GliderWinchItems/BMScable/README.md

# BMSCable
Battery Management System Cable testing unit

Test the cable from the battery module (before connecting to the BMS control pcb!).
