GliderWinchItems/BMScable/pcb/docs/description/BMSCable.odt

Overview

The BMScable pcb fulfills the primary function of testing the battery module cable (ribbon cable with IDC connector) from the cells to the BMS board for correct wiring prior to plugging the cable into the BMS board. A wrong connection has the possibility of ruining the BMS unit.

A secondary use of the BMScable board might be monitoring the cell and battery string voltages and controlling the on/off of an external charger to that battery string.

In its rudimentary configuration the BMScable board is not isolated from the battery and a usb connection places the computer at the battery string ground.

The basic function is to measure all pins of the battery module cable, with respect to the expected ground pin, and determine if the voltages are within limits for a correctly connected cable. Since any wire might carry full battery module voltage all the pins, except for ground, connect to a resistor divider that drops the maximum possible voltage to be within the limit of the processor ADC.

Since the processor can only handle 16 inputs, three addition measurements are provided by switching three ADC inputs between six IDC pins. Three of the connectors are for measuring battery current, plus a Kelvin ground. Two DPDT relays are used switch these inputs, (one of the relay poles unused).

Since the three wires expected to be essentially ground when correctly wired are checked for voltage near zero, which expected for a correct connection; above the voltage for a single cell a low charge, which would signal an incorrect wiring; and, in between these two limits if the wire is open-circuit. A large pull-up resistor to 5v provides the voltage to the divider that will show open circuit.

When the relays are energized all the ADC inputs connect to the 16 battery module cells (via the resistor divider).

Individual cell voltages can be computed by taking the difference between cell readings (but with starting with cell #1 and ground). Since the resistor divider divides by nearly 20x, the difference between cell readings is magnified. Individual cell voltages can have an error upwards of +/- 0.12v, with cell pairs having showing the plus and the other showing the minus error.

PCB layout features

The pcb layout was made with the intent to be able to use it with a STM32 Nucleo board, or mount a STM32F405,407,446, or STM32L431 directly onto the pcb. The board fab, PCBCart.com, offers an inexpensive proto-type service, but that service does not include solder stop mask between smd pads for the processor. If attempts to mount the processor on the pcb resulted in difficulties with solder bridges, then the boards could be used with the Nucleo boards. The layout included headers that would mate with the Nucleo board.

The direct mounting of a STM32L431RBT6 proved satisfactory so the assembly and the following do not include the provisions for the configuration with the Nucleo board.

Serial port monitoring is via usb-serial module that can be mounted with headers. The usb can supply the ~5v for running the processor. The header JP2 requires a jumper to supply the 5v from the usb-serial module.

Note: The usb-serial module should not have the jumper in place.

The 2x10 IDC connector is keyed so that the ribbon cable connector only inserts in one orientation.

A reset pushbutton is located near the IDC connector.

A 3-pin keyd connector, also near the IDC connector, is for connecting the fet to something external to turn an external charger on/off, e.g. an external relay, or solid-state relay. A flyback diode is included in case a relay is used.

A two pin header was mounted on the lower 2x20 header in the ground positions. This two pin header provides a ground connection for a VOM.

A one-pin header is tack-mounted on the +3.3v output of the 5→3.3v regulator. This provides a convenient place for a VOM to measure Vdd. This voltage source can be used for testing.

All pins except pin #3 on the IDC connector connect to resistors.

Schottky diodes are included to prevent negative voltages on the ADC inputs should the ribbon cable be backwards (which would occur if the IDC connector was crimped on incorrectly).

Wiring

A 20 wire, multi-color ribbon is used. The cell designation for the wires has the ribbon split so for an upper section goes on top of the battery module, and a lower section to the underside. The cell connections are made so that the wires peel off the ribbon in order as it progresses down the top, and bottom, sides of the battery module. This results in the following cell number versus ribbon color, versus IDC connector pin number.

X

Flashing & Debugging

Header JP6 SWD connects to a Nucleo or DiscoveryFx board SWD for flashing and debugging using the STLink. On the Nucleo, or other,

1) Remove the two jumpers to enable the SWD header.

2) On the Nucleo board enable the 5v from the USB by a jumper, U5V on jp5, to power ST-Link processor (not needed on the Discovery boards).

3) The BMScable board is powered via the USB-serial cable.

The STLink connections between the two boards--

Nucleo/DiscoverFx

BMScable

1

2 2

3 1 (gnd)

4 3

5

6

On the PC, openocd the following configuration command opens the openocd server for debugging--

openocd -f interface/stlink.cfg -f target/stm32l4x.cfg

Something similar to the following should be seen--

openocd -f interface/stlink.cfg -f target/stm32l4x.cfg

Open On-Chip Debugger 0.11.0+dev-00282-gae6de2f93-dirty (2021-07-29-16:35)

Licensed under GNU GPL v2

For bug reports, read

http://openocd.org/doc/doxygen/bugs.html

Info : auto-selecting first available session transport "hla_swd". To override use 'transport select <transport>'.

Info : The selected transport took over low-level target control. The results might differ compared to plain JTAG/SWD

Info : DEPRECATED target event trace-config

Info : Listening on port 6666 for tcl connections

Info : Listening on port 4444 for telnet connections

Info : clock speed 500 kHz

Info : STLINK V2J38M27 (API v2) VID:PID 0483:374B

Info : Target voltage: 3.255445

Info : stm32l4x.cpu: hardware has 6 breakpoints, 4 watchpoints

Info : starting gdb server for stm32l4x.cpu on 3333

Info : Listening on port 3333 for gdb connections

[Sucess in connecting]

Sometimes the flashing of the 'L431 ends with failure with a message about failing to erase. When this happens often it works with the next './mm' try. Sometimes it takes unplugging/repowering. Sometimes pressing the reset pushbutton on the BMScable board starts it. I’m not sure what is going on. Most of the time it works OK.

In another window the following starts the rudimentary debugger--

telnet localhost 4444

Program

The program makes use of prior routines and as such may include code not used in this application.

The ADC parameters are initialized with a call to the routine in adc_idx_v_struct.c. A default calibration based on nominal values is first set, and specific calibrations replace the values based on #ifdef--#endif sections which select the board number.

Don’t forget to use the correct the #define to select the board number.

ADCTask.c runs the task that handles the ADC.

Sixteen ADCs are read using DMA in a continuous scan mode. The auto injection is set so that following the 16th conversion the injection sequence is started. This sequence measures the internal voltage reference and internal temperature sensor. Upon DMA interrupt the prior injection data registers are stored.

Upon interrupt, the DMA half buffer with the readings just completed are summed. After 16 summations the summations for the sixteen inputs are converted to floats and pasted through single-pole filters. The buffers are swapped and ‘main’ is given a notification.

main.c waits for notifications and counts notifications to reduce the output rate. The output (subject to change) presents column headers for the cell number, ribbon color, and connector pin number. The data rows present the ribbon voltages and on the following line the differences which should be the individual cell voltages.

The header with the cell number has three forms--

- Cell OK: e.g. ‘1 ’

- Cell too low: e.g. ‘1 LO’

-Cell too hi: e.g. ‘1 HI’

The calibration adc_idx_v_struct.c sets the threshold for the high and low limits. When the voltage is outside these limits the fet for controlling an external charger is off. When within the limits the external fet is turned on if the overall battery module voltage (16th cell voltage) is not too high.

Cable not plugged in--

PIN# 13 5 14 6 15 7 16 8 17 9 18 10 19 11 20 12

COLORGRY BLU PUR GRN BLU YEL GRN ORG YEL RED ORG BRN RED BLK BRN WHT

CELL 1 LO 2 LO 3 LO 4 LO 5 LO 6 LO 7 LO 8 LO 9 LO 10 LO 11 LO 12 LO 13 LO 14 LO 15 LO 16 LO

D: 0.0000 0.0000 -0.0000 0.0000 0.0000 0.0000 0.0000 0.0000 0.0000 0.0000 0.0000 0.0000 0.0000 0.0000 0.0000 0.0000

N: 0.0000 0.0000 0.0000 0.0000 0.0000 0.0000 0.0000 0.0000 0.0000 0.0000 0.0000 0.0000 0.0000 0.0000 0.0000 0.0000

STATUS: FET OFF : Vref 12045 Vtemp 7426

Z: SRN OPEN 2.308 SRP OPEN 2.302 C0 OPEN 2.292

Cable plugged in--

PIN# 13 5 14 6 15 7 16 8 17 9 18 10 19 11 20 12

COLORGRY BLU PUR GRN BLU YEL GRN ORG YEL RED ORG BRN RED BLK BRN WHT

CELL 1 2 3 4 5 6 7 8 9 10 11 12 13 14 15 16

D: 3.8922 3.8467 3.8661 3.8444 3.9163 3.7115 3.8851 3.8984 3.8910 3.8100 3.8843 3.8903 3.8054 3.9127 3.8813 3.8813

N: 3.8922 7.7389 11.6051 15.4494 19.3657 23.0773 26.9623 30.8607 34.7518 38.5618 42.4461 46.3364 50.1418 54.0545 57.9358 61.8171

STATUS: FET ON : Vref 12033 Vtemp 7502

Z: SRN GOOD 0.000 SRP GOOD 0.000 C0 GOOD 0.000

LEDs

Two processor controlled LEDs (located near JP6 SWD header)--

The red led (next to the green led) is ON with the fet is ON.

The green led flashes to indicate normal program

Both flashing together gives the Morse code trap code number.

Two polarity check LEDs (located at board edge near IDC connector--

The green LED indicates correct ribbon polarity.

The red LED indicates the ribbon/IDC is backwards.

Calibration

Each ADC input requires a calibration. To ease the burden the following scheme using the spreadsheet GliderWinchItems/BMScable/pcb/docs/calibration/calibration-aids.ods can be used.

1) Measure the ground-to-cell voltages and enter them in the horizontal row of the spreadsheet labelled VOM measurement.

2) Copy the existing calibration table in adc_idx_v_struct.c and paste into the spreadsheet “top” list of calibrations in the spreadsheet (paste to cell A18).

3) Copy the newly computed calibration table from the “bottom” list of calibrations (copy A37:D55, don’t forget the “;” column) and paste into adc_idx_v_struct.c

4) Convert the spreadsheet right arrow p→ to p-> with find and “replace all”.

5) Recompile

BMScable unit – Description and notes 08/22/2021 Page 6
