GliderWinchItems/BMScable/pcb/openscad/pcb-frame.stl

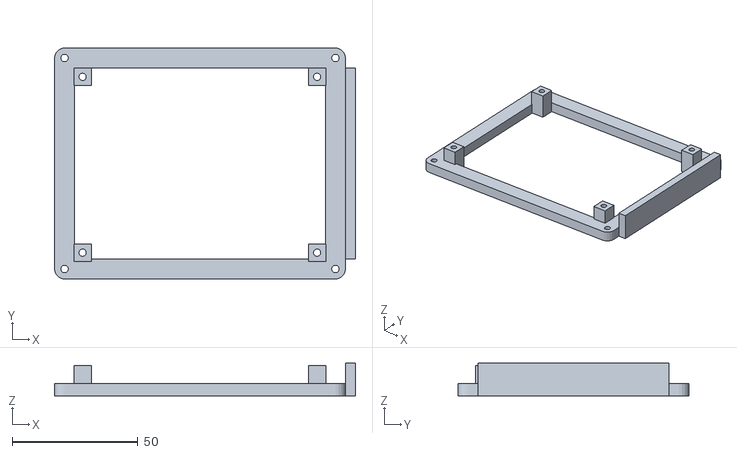
[picture p6: CAD file, 2021-08-24]
pcb/openscad/pcb-frame.stl
119.9 x 92.0 x 13.0
