GliderWinchItems/BMScable/perf/hw/eagle/pinusage.ods

 | Nucleo446R |  |  |  |  | 07/24/20
Row |  | Processor | Nucleo |  |  |  |  | Nucleo
Seq # |  | pin | CN7 | CN10 |  |  |  | note
1 | PA00 | 14 | 28 |  | ADC123-IN0 | C1 | PUSHBUTTON (PULLUP)
2 | PA01 | 15 | 30 |  | ADC123-IN1 | C2
3 | PA02 | 16 |  | 35 | ADC123-IN2 | C3
4 | PA03 | 17 |  | 37 | ADC123-IN3 | C4
5 | PA04 | 20 | 32 |  | ADC123-IN4 | C5
6 | PA05 | 21 |  | 11 | ADC123-IN5 | C6
7 | PA06 | 22 |  | 13 | ADC123-IN6 | C7
8 | PA07 | 23 |  | 16 | ADC123-IN7 | C8
9 | PA08 | 41 |  | 23 | TIM1_CH1
10 | PA09 | 42 |  | 21 | USART1_TX | JP2-9 | FTDI
11 | PA10 | 43 |  | 33 | USART1_RX | JP2-10 | FTDI
12 | PA11 | 44 |  | 14 | CAN1_RX | JP2-4 | CAN-RX
13 | PA12 | 45 |  | 12 | CAN1_TX | JP2-3 | CAN-TX
14 | PA13 | 46 | 13 |  | SWDIO |  | JTMS
15 | PA14 | 49 | 15 |  | SWDCK |  | JTCK
16 | PA15 | 50 |  |  | --
17
18 | PB00 | 26 | 34 |  | ADC123_IN8 | C9
19 | PB01 | 27 |  | 24 | ADC123_IN9 | C10
20 | PB02 | 28 |  | 22 | BOOT1
21 | PB03 | 55 |  | 31 | OUT PP | Q12-FET-RELAY
22 | PB04 | 56 |  | 27 | --
23 | PB05 | 57 |  | 29 | CAN2-RX
24 | PB06 | 58 |  | 17 | CAN2-TX
25 | PB07 | 59 | 21 |  | I/O
26 | PB08 | 61 |  | 3 | TIM4CH3 | FET-CHGR-RELAY
27 | PB09 | 62 |  | 5 | OUTPUT
28 | PB10 | 29 |  | 25 | I2C2-SCL
29 | VCAP_1 | 30 |  |  | VCAP_1
30 | PB12 | 33 |  | 16 | CAN2-RX
31 | PB13 | 34 |  | 30 | CAN2-TX
32 | PB14 | 35 |  | 28 | I/O
33 | PB15 | 36 |  | 26 | I/O
34
35 | PC00 | 8 | 38 |  | ADC123-IN10 | C11
36 | PC01 | 9 | 36 |  | ADC123-IN11 | C12 | Nucleo PB8
37 | PC02 | 10 | 35 |  | ADC123-IN12 | C13 | Nucleo PB9
38 | PC03 | 11 | 37 |  | ADC123-IN13 | C14
39 | PC04 | 24 | 34 |  | ADC123_IN14 | C15|C17
40 | PC05 | 25 |  | 6 | ADC123-IN15 | C16|C18
41 | PC06 | 37 |  | 4 | TIM8CH1
42 | PC07 | 38 |  | 19 | TIM3CH2
43 | PC08 | 39 |  | 2 | SDIO-D0
44 | PC09 | 40 |  | 1 | SDIO-D1
45 | PC10 | 51 | 1 |  | SDIO-D2
46 | PC11 | 52 | 2 |  | SDIO-D3
47 | PC12 | 53 | 3 |  | SDIO-CK
48 | PC13 | 2 | 23 |  | --
49 | PC14 | 3 | 25 |  | OSC32_IN
50 | PC15 | 4 | 27 |  | OSC32_OUT
51
52 | PD2 | 54 | 4 |  | SDIO-CMD | U$26
53
54 | PH00 | 5 | 29 |  | OSC-IN | XTAL 8 MHZ
55 | PH01 | 6 | 31 |  | OSC-OUT | XTAL 8 MHZ
56
57 | VBAT | 1 | 33 |  |  |  |  | SB45 zero to VDD
58
59 | VDD | 64 | 5 |  | VCC
60 | VSS | 63 |  |  | GND
61
62 | VSS | 18 |  |  | GND |  |  | SB53 zero
63 | VDD | 19 |  |  | VCC
64 | VDD | 48 |  |  | VCC
65 | VSS | 47 |  |  | GND |  |  | SB33 zero
66
67 | VDD | 32 |  |  | VCC
68 | VSS | 31 | 8 |  | GND |  |  | SB38 zero
69
70 | VSSA | 12 |  | 32 | GND
71 | VDDA | 13 |  | 7 | VCC | via BEAD to VDD |  | SB57 zero
72
73 | BOOT0 | 60 | 7 |  | GND
74
75 | NRST | 7 | 14 |  | NRST | JP1-26 | ONBOARD PUSHBUTTON
76 |  | np | 9
77 |  | np | 10
78 | IOREF | np | 11
79 |  | np | 26
80 |  | np |  | 10
81 |  | np |  | 18
82 |  | np |  | 36
83 |  | np |  | 38
84 | +5V | np | 18
85 | E5V | np | 6
86 | U5V | np |  | 8
