GliderWinchItems/BMScable/pcb/docs/calibration/boards.ods

Sheet: Sheet1
docs/calibration/boards
 |  |  |  |  |  |  |  |  |  |  |  |  | 12 | 14 | 8 | 10 | 4 | 6 | 0 | 2 | 13 | 15 | 9 | 11 | 5 | 7 | 3 | 1
08/09/21 |  |  |  |  |  |  |  |  |  |  |  |  | 1 | 2 | 3 | 4 | 5 | 6 | 7 | 8 | 9 | 10 | 11 | 12 | 13 | 14 | 15 | 16
 |  |  |  |  |  |  |  |  |  |  |  |  | 51.1132 | 58.9712 | 35.383 | 43.2672 | 19.6037 | 27.304 | 3.9166 | 11.6635 | 54.7522 | 62.6399 | 39.1192 | 46.8919 | 23.4117 | 31.2286 | 15.5458 | 7.779
 |  |  |  |  |  |  |  |  |  |  |  |  | 3.9901 | 8.0683 | 11.9288 | 15.9575 | 20.0204 | 24.0409 | 28.3476 | 32.1452 | 36.2471 | 40.0529 | 43.7685 | 47.9679 | 56.2892 | 45.6854 | 59.8037 | 64.0693 | : 120 | 40 7516
 |  |  |  | Connector |  |  |  |  |  |  |  |  | 4 | 8 | 12 | 16 | 20 | 24 | 28 | 32 | 36 | 40 | 44 | 48 | 52 | 56 | 60 | 64
 | Vbat | ADC[x] | Ribbon color | pin number |  | Cal reading |  |  |  | ADC[INx] | Ribbon color | pin number | cell number | I/O Port |  | ADC() | cell()
 | 3.299 | 2 | BRN | 20 | PC1 | 3.346 | 1.014247 |  |  | 2 | BRN | 20 | 15 | PC1 |  | 1 | 13 | 12
 | 3.299 | 1 | RED | 19 | PC0 | 3.370 | 1.021522 |  |  | 1 | RED | 19 | 13 | PC0 |  | 2 | 15 | 14
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
