GliderWinchItems/BMScable/pcb/docs/calibration/calibration-aid.ods

Calibration-aid
08/22/21
 | Readings
 | 1 | 2 | 3 | 4 | 5 | 6 | 7 | 8 | 9 | 10 | 11 | 12 | 13 | 14 | 15 | 16
D: | 3.8891 | 3.8515 | 3.9967 | 3.9846 | 3.9764 | 3.7139 | 3.5913 | 4.1201 | 3.5226 | 4.2435 | 4.5077 | 3.4556 | 3.8726 | 3.4724 | 4.1809 | 4.3614
N: | 3.8891 | 7.7406 | 11.7373 | 15.7219 | 19.6983 | 23.4121 | 27.0035 | 31.1236 | 34.6462 | 38.8897 | 43.3974 | 46.853 | 50.7256 | 54.198 | 58.3789 | 62.7403
VOM measurement | 0.0000 | 0.0000 | 0.0000 | 0.0000 | 0.0000 | 0.0000 | 0.0000 | 0.0000 | 0.0000 | 0.0000 | 0.0000 | 0.0000 | 0.0000 | 54.5110 | 58.4060 | 62.3070
Ratio | #DIV/0! | #DIV/0! | #DIV/0! | #DIV/0! | #DIV/0! | #DIV/0! | #DIV/0! | #DIV/0! | #DIV/0! | #DIV/0! | #DIV/0! | #DIV/0! | #DIV/0! | 0.9942580 | 0.9995360 | 1.0069543
 | Calibration table
 | used for readings
p->cabs[ 0].scale = | 1.236120E-04 | ; | x
p->cabs[ 1].scale = | 1.211896E-04 | ; | x
p->cabs[ 2].scale = | 1.217631E-04 | ; | x
p->cabs[ 3].scale = | 1.215495E-04 | ; | x
p->cabs[ 4].scale = | 1.215893E-04 | ; | x
p->cabs[ 5].scale = | 1.206427E-04 | ; | x
p->cabs[ 6].scale = | 1.216620E-04 | ; | x |  |  |  |  |  |  |  |  |  |  | meter | board | ratio | update factor | value
p->cabs[ 7].scale = | 1.226831E-04 | ; | x |  |  |  |  |  |  |  |  |  |  | 62.0240 | 62.0028 | 1.00034192 | 1.211783E-04 | 1.211369E-04
p->cabs[ 8].scale = | 1.215362E-04 | ; | x
p->cabs[ 9].scale = | 1.201768E-04 | ; | x
p->cabs[10].scale = | 1.212922E-04 | ; | x
p->cabs[11].scale = | 1.218116E-04 | ; | x
p->cabs[12].scale = | 1.215921E-04 | ; | x
p->cabs[13].scale = | 1.221255E-04 | ; | x
p->cabs[14].scale = | 1.205759E-04 | ; | x
p->cabs[15].scale = | 1.211369E-04 | ; | x
p->cabs[16].scale = | 1.211369E-04 | ;
p->cabs[17].scale = | 1.211369E-04
New calibration = adjusted above calibration |  |  |  |  |  |  |  |  | nominal
p→cabs[ 0].scale = |  | 1.236120E-04 | ; | x |  |  |  |  | divider | Board #2 |  | After division
p→cabs[ 1].scale = |  | 1.211896E-04 | ; | x |  | R1 | R2 | R1+R2 | ratio | Vdd | Vdd/4095 | mv/lsb
p→cabs[ 2].scale = |  | 1.217631E-04 | ; | x |  | 680 | 33 | 713 | 0.04628331 | 3.3033 | 0.0008066667 | 0.0174
p→cabs[ 3].scale = |  | 1.215495E-04 | ; | x
p→cabs[ 4].scale = |  | 1.215893E-04 | ; | x
p→cabs[ 5].scale = |  | 1.206427E-04 | ; | x
p→cabs[ 6].scale = |  | 1.216620E-04 | ; | x
p→cabs[ 7].scale = |  | 1.226831E-04 | ; | x
p→cabs[ 8].scale = |  | 1.215362E-04 | ; | x
p→cabs[ 9].scale = |  | 1.201768E-04 | ; | x
p→cabs[10].scale = |  | 1.212922E-04 | ; | x
p→cabs[11].scale = |  | 1.218116E-04 | ; | x
p→cabs[12].scale = |  | 1.215921E-04 | ; | x
p→cabs[13].scale = |  | 1.221255E-04 | ; | x
p→cabs[14].scale = |  | 1.205759E-04 | ; | x
p→cabs[15].scale = |  | 1.211369E-04 | ; | x
p→cabs[16].scale = |  | 1.211369E-04 | ;
p→cabs[17].scale = |  | 1.211369E-04 | ;
