GliderWinchItems/BMScable/pcb/docs/calibration/board2.ods

docs/alibration/board2
08/09/21
 |  |  |  | Connector
 | Vbat | ADC[x] | Ribbon color | pin number |  | Cal reading
 | 3.299 | 2 | BRN | 20 | PC1 | 3.346 | 1.014247
 | 3.299 | 1 | RED | 19 | PC0 | 3.370 | 1.021522
 | 3.299 | 4 | ORG | 18 | PC3 | 3.349 | 1.015156
 | 3.299 | 3 | YEL | 17 | PC2 | 3.351 | 1.015762
 | 3.299 | 6 | GRN | 16 | PA1 | 3.373 | 1.022431
 | 3.299 | 5 | BLU | 15 | PA0 | 3.345 | 1.013944
 | 3.299 | 8 | PUR | 14 | PA3 | 3.343 | 1.013337
 | 3.299 | 7 | GRY | 13 | PA2 | 3.374 | 1.022734
 | 3.299 | 10 | WHT | 12 | PA5 | 3.347 | 1.014550
 | 3.299 | 9 | BLK | 11 | PA4 | 3.372 | 1.022128
 | 3.299 | 12 | BRN | 10 | PA7 | 3.404 | 1.031828
 | 3.299 | 11 | RED | 9 | PA6 | 3.357 | 1.017581
 | 3.299 | 14 | ORG | 8 | PC5 | OC |  | RY2-2-NC
 | 3.299 | 13 | YEL | 7 | PC4 | OC
16? | 3.299 | 15 | GRN | 6 | PB0 | 3.390 | 1.027584 | RY2-1-NC
15? | 3.299 |  | BLU | 5 | PB1 | OC |  | RY1-2-NC
 | C0 |  | PUR | 4
 | ground |  | GRY | 3
 | SRN |  | WHT | 2
 | SRP |  | BLK | 1
 | 3.299 |  | Vrefint |  |  | 3.303 |  | 1.001212
 |  |  | Vtemp |  |  | 924.17
BOARD #2 | 08/10/21
 |  |  | 0 | 1 | 2 | 3 | 4 | 5 | 6 | 7 | 8 | 9 | 10 | 11 | 12 | 13 | 14 | 15 | 16
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
