GliderWinchItems/BMScable/pcb/BMScableL431/eagle/bmscableL431.brd

## EAGLE design pcb/BMScableL431/eagle/bmscableL431.brd (2021-02-24)

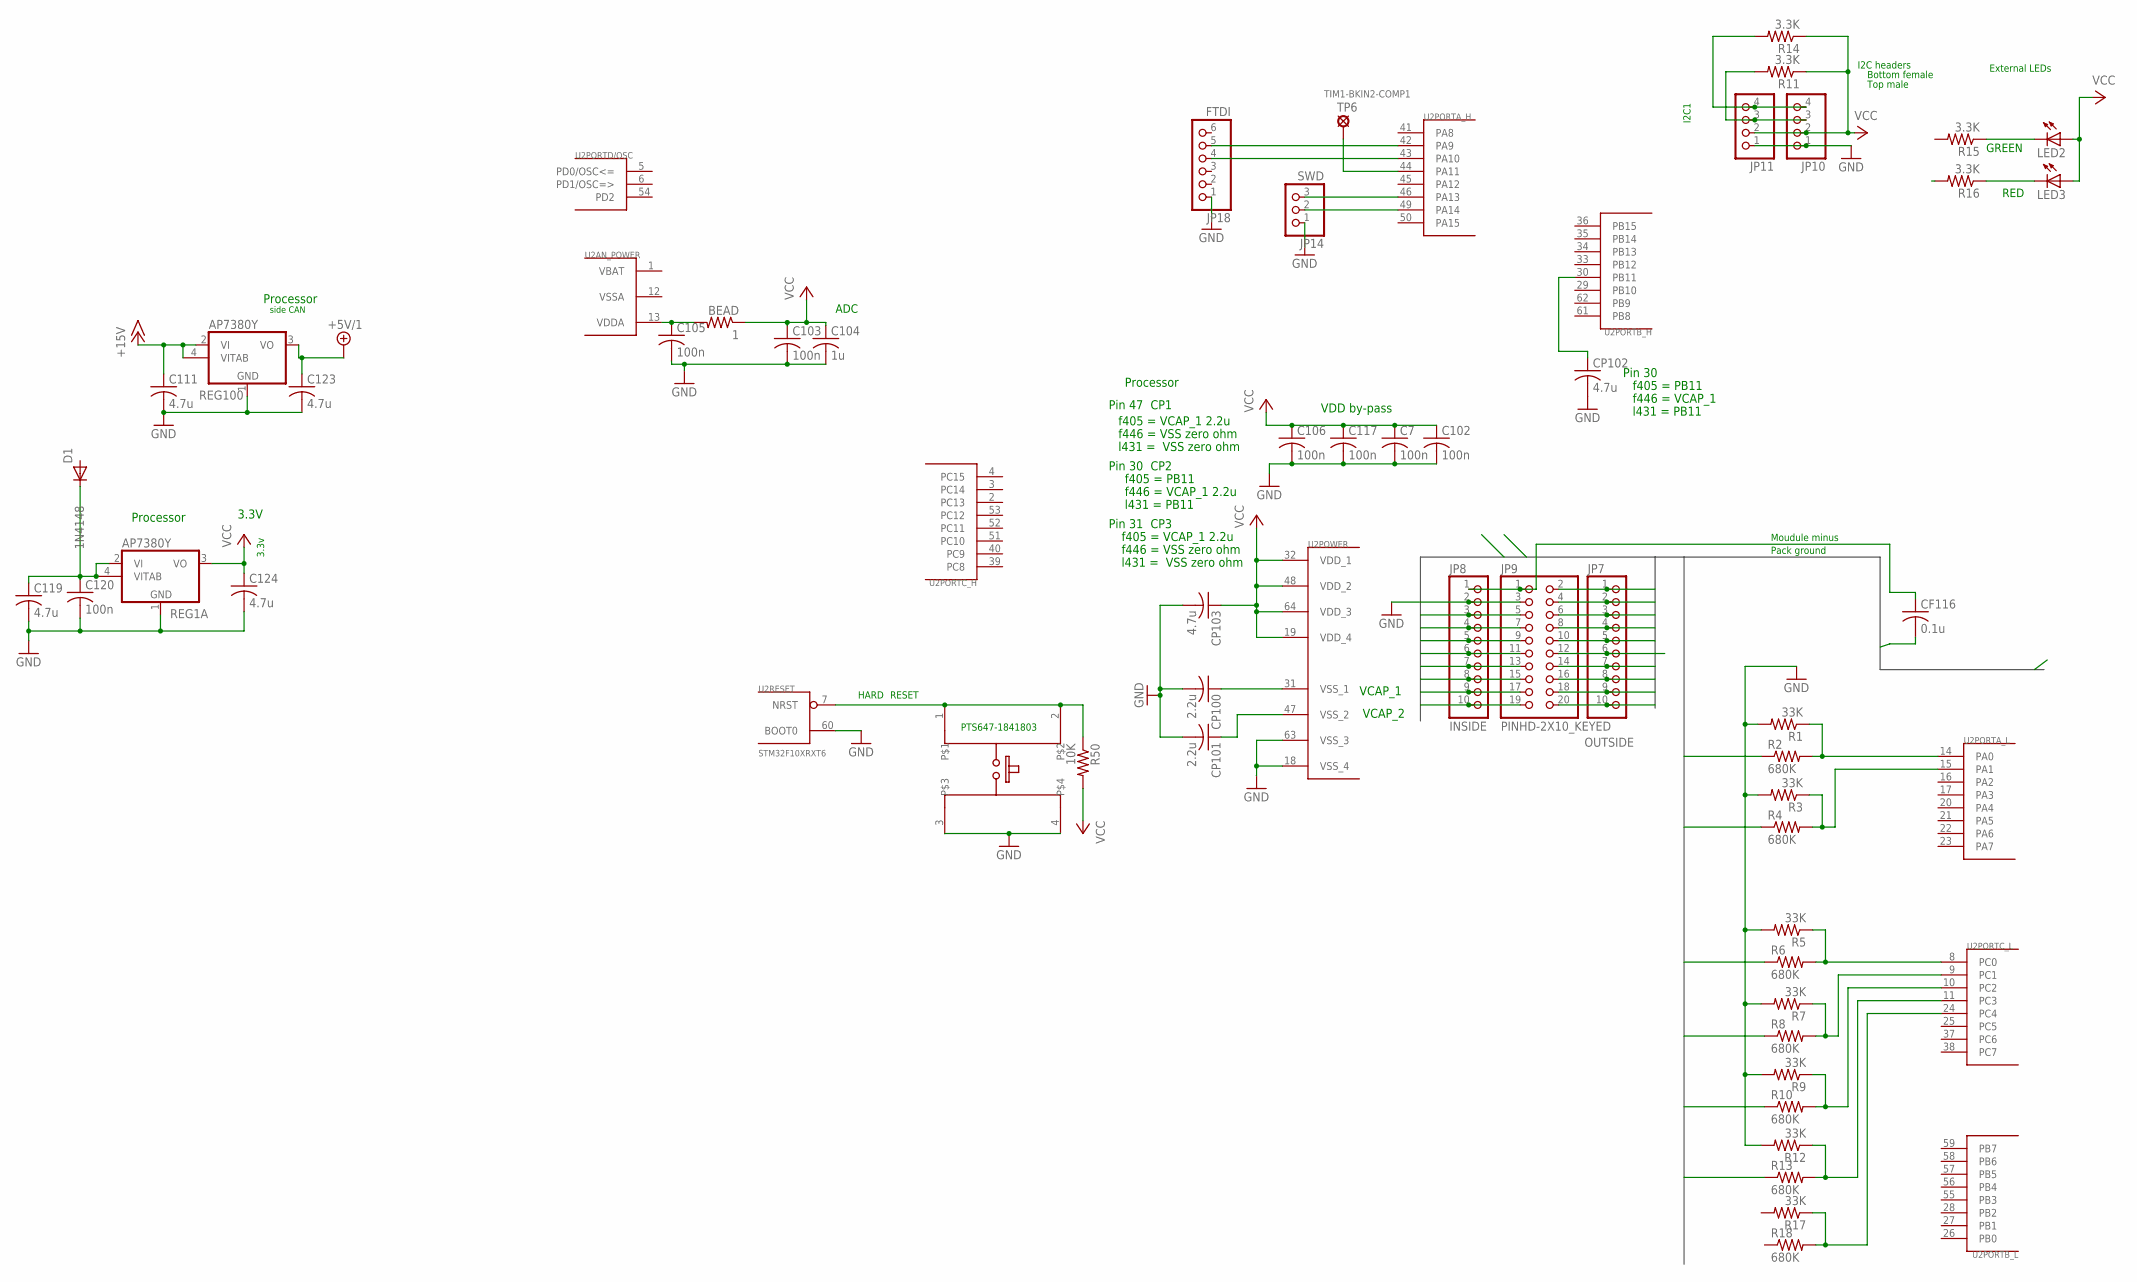
[picture p7: schematic bmscableL431.sch]

Parts:
BEAD: 1; R0603
C7, C102, C103, C105, C106, C117, C120: 100n; C0603
C104: 1u; C0603
C111, C119, C123: 4.7u; C0603
C124: 4.7u; C0805
CF116: 0.1u; C0603
CP100, CP101: 2.2u; C0603
CP102, CP103: 4.7u; C0603
D1: 1N4148; DO41-10_VERT
JP7: OUTSIDE; 1X10
JP8: INSIDE; 1X10
JP9: PINHD-2X10_KEYED; 2X10_KEYED
JP10, JP11: PINHD-1X4; 1X04
JP14: SWD; 1X03
JP18: FTDI; 1X06
LED2, LED3: LEDCHIP-LED0603; CHIP-LED0603
R1, R3, R5, R7, R9, R12, R17: 33K; R0603
R2, R4, R6, R8, R10, R13, R18: 680K; R0603
R11, R14, R15, R16: 3.3K; R0603
R50: 10K; R0603
REG1A, REG100: AP7380Y; SOT89
TP6: SOLDPAD0.6MM; SOLPAD.6MM
U2: STM32F10XRXT6; TQFP64
U$1: E-SWITCH2

Connections:
+5V/1: C123.1, REG100.3 (VO)
+15V: C111.1, REG100.2 (VI), REG100.4 (VITAB)
C0: JP7.2, JP9.4
C1: JP8.7, JP9.13
C2: JP8.3, JP9.5
C3: JP7.7, JP9.14, R4.1
C4: JP7.3, JP9.6
C5: JP8.8, JP9.15, R2.1
C6: JP8.4, JP9.7
C7: JP7.8, JP9.16, R13.1
C8: JP7.4, JP9.8
C9: JP8.9, JP9.17, R10.1
C10: JP8.5, JP9.9
C11: JP7.9, JP9.18, R8.1
C12: JP7.5, JP9.10
C13: JP8.10, JP9.19, R6.1
C14: JP8.6, JP9.11
C15: JP7.10, JP9.20
C16: JP7.6, JP9.12
GND: C7.2, C102.2, C103.2, C104.2, C105.2, C106.2, C111.2, C117.2, C119.2, C120.2, C123.2, C124.2, CP100.2, CP101.2, CP102.2, CP103.2, JP8.2, JP9.3, JP10.1, JP11.1, JP14.1, JP18.1, R1.2, R3.2, R5.2, R7.2, R9.2, R12.2, REG1A.1 (GND), REG100.1 (GND), U2.18 (VSS_4), U2.60 (BOOT0), U2.63 (VSS_3), U$1.3, U$1.4
LED-EXT-GRN-CATHODE: LED2.C, R15.1
LED-EXT-RED-CATHODE: LED3.C, R16.1
NRST: R50.1, U2.7 (NRST), U$1.1, U$1.2
PA0-C5-IN5: R1.1, R2.2, U2.14 (PA0)
PA1-C3-IN6: R3.1, R4.2, U2.15 (PA1)
PA9-USART1-TX: JP18.5, U2.42 (PA9)
PA10-USART1-RX: JP18.4, U2.43 (PA10)
PA13-SWDIO: JP14.3, U2.46 (PA13)
PA14-SWCLK: JP14.2, U2.49 (PA14)
PB1-LED-RED: R16.2
PB6-I2C1-SCL: JP10.4, JP11.4, R14.2
PB7-I2C2-SDA: JP10.3, JP11.3, R11.2
PB11-I2C2-SDA|VCAP1: CP102.1, U2.30 (PB11)
PC0-C13-IN1: R5.1, R6.2, U2.8 (PC0)
PC1-C11-IN2: R7.1, R8.2, U2.9 (PC1)
PC2-C9-IN3: R9.1, R10.2, U2.10 (PC2)
PC3-C7-IN4: R12.1, R13.2, U2.11 (PC3)
PC4-CX-IN13: R17.1, R18.2, U2.24 (PC4)
PGND_SRN_V: CF116.1, JP8.1, JP9.1
SRP: CF116.2, JP7.1, JP9.2
TIM1_BKIN2_COMP2: TP6.MP, U2.44 (PA11)
V-ORED: C119.1, C120.1, D1.C, REG1A.2 (VI), REG1A.4 (VITAB)
VBAT: U2.1 (VBAT)
VCC: BEAD.1, C7.1, C102.1, C103.1, C104.1, C106.1, C117.1, C124.1, CP103.1, JP10.2, JP11.2, LED2.A, LED3.A, R11.1, R14.1, R50.2, REG1A.3 (VO), U2.19 (VDD_4), U2.32 (VDD_1), U2.48 (VDD_2), U2.64 (VDD_3)
VDDA1: BEAD.2, C105.1, U2.13 (VDDA)
VSSA: U2.12 (VSSA)
VSS_1-VCAP_1: CP100.1, U2.31 (VSS_1)
VSS_3: CP101.1, U2.47 (VSS_2)

Notes on the sheet:
RESET
HARD
3.3V
VCAP_1
VCAP_2
Pin 47
f405 = VCAP_1 2.2u
Pin 30
f446 = VCAP_1 2.2u
Pin 31
f446 = VSS zero ohm
CP1
CP3
f405 = PB11
f446 = VCAP_1
CP2
ADC
GREEN
RED
I2C headers
Bottom female
3.3v
Processor
PTS647-1841803
Moudule minus
Pack ground
External LEDs
side CAN
TIM1-BKIN2-COMP1
l431 = VSS zero ohm
l431 = PB11
VDD by-pass
Top male
I2C1

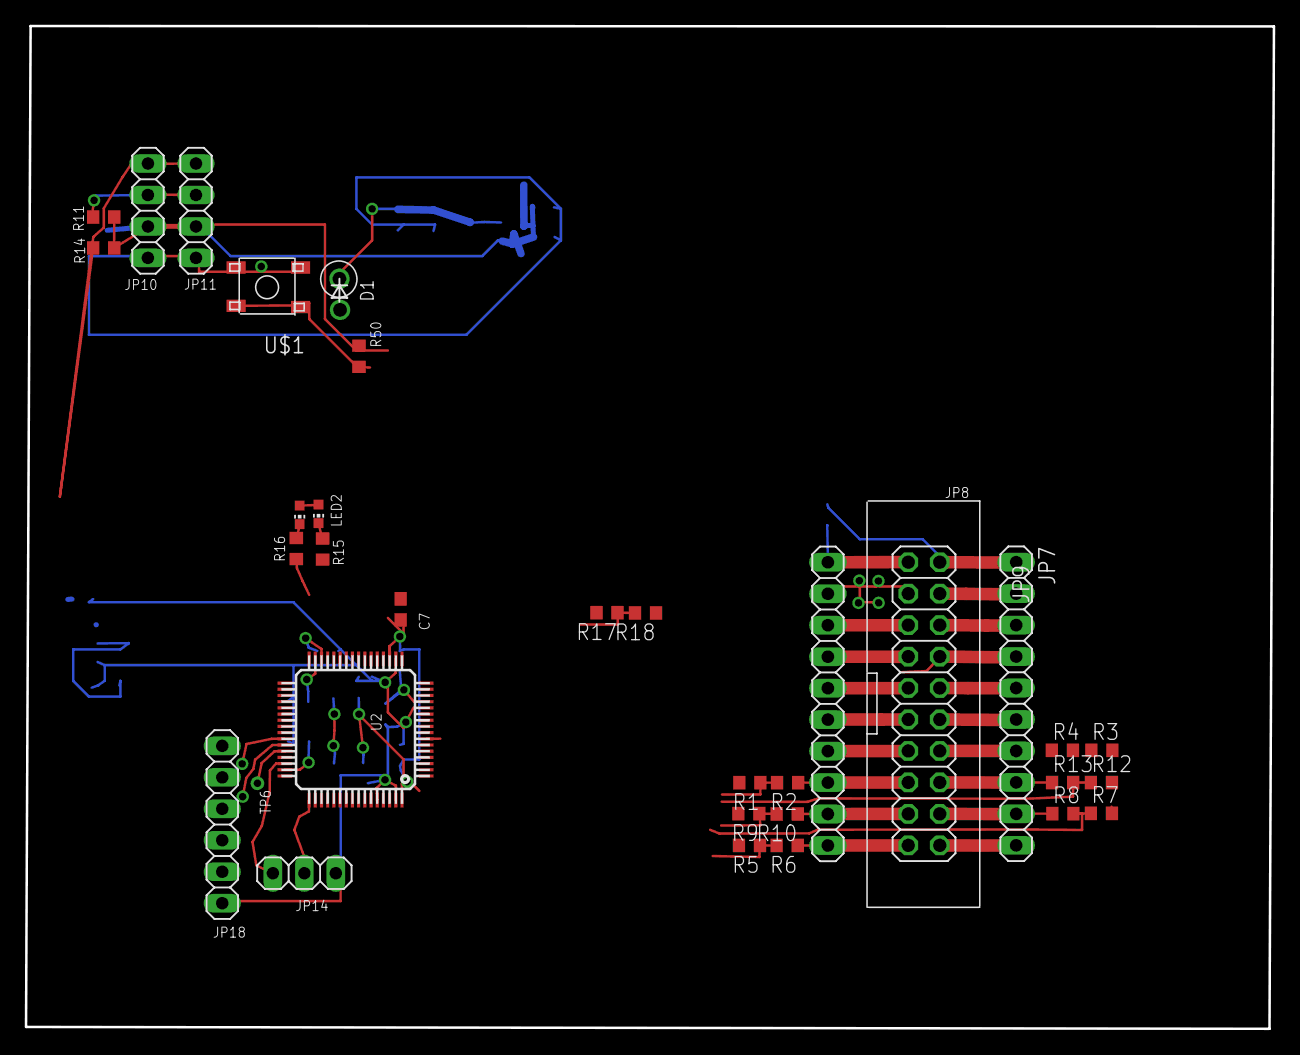
[picture p8: board bmscableL431.brd from above]

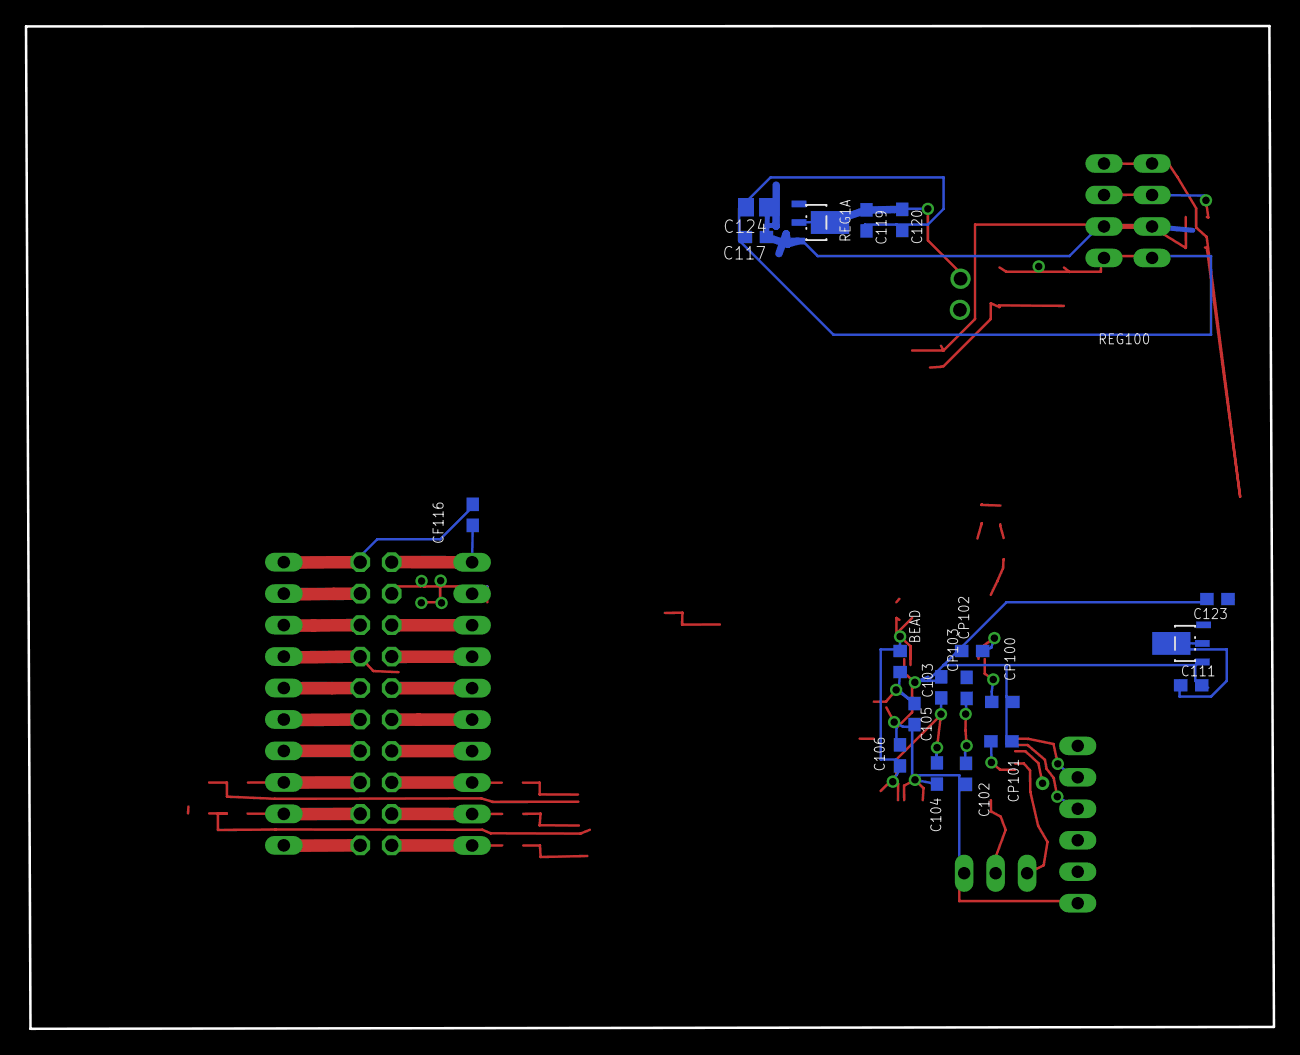
[picture p9: board bmscableL431.brd from below]

Board: 2 copper layers, 100.7 x 81.0 mm, 52 parts (19 on the bottom side), 45 nets.
