GliderWinchItems/BMScable/pcb/BMScableL431/Core/Src/main.c

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
/* Includes ------------------------------------------------------------------*/
#include "main.h"
#include "cmsis_os.h"

/* USER CODE BEGIN Includes */
#include <string.h>
#include "SerialTaskSend.h"
#include "getserialbuf.h"
#include "stackwatermark.h"
#include "yprintf.h"
#include "DTW_counter.h"
#include "SerialTaskReceive.h"
#include "yscanf.h"
#include "morse.h"

#include "FreeRTOS.h"
#include "semphr.h"

#include "adcparams.h"
#include "ADCTask.h"



/* USER CODE END Includes */

ADC_HandleTypeDef hadc1;
DMA_HandleTypeDef hdma_adc1;

CAN_HandleTypeDef hcan1;

UART_HandleTypeDef huart1;
DMA_HandleTypeDef hdma_usart1_rx;
DMA_HandleTypeDef hdma_usart1_tx;

/* Definitions for defaultTask */
osThreadId_t defaultTaskHandle;
const osThreadAttr_t defaultTask_attributes = {
  .name = "defaultTask",
  .stack_size = 384 * 4,
  .priority = (osPriority_t) osPriorityNormal,
};
void SystemClock_Config(void);
static void MX_GPIO_Init(void);
static void MX_DMA_Init(void);
static void MX_ADC1_Init(void);
static void MX_USART1_UART_Init(void);
static void MX_CAN1_Init(void);
void StartDefaultTask(void *argument);

/**
  * @brief  The application entry point.
  * @retval int
  */
int main(void)
{
  /* USER CODE BEGIN 1 */
  BaseType_t ret;    // Used for returns from function calls
  //osMessageQId Qidret; // Function call return
  osThreadId Thrdret;  // Return from thread create
  /* USER CODE END 1 */

  /* MCU Configuration--------------------------------------------------------*/

  /* Reset of all peripherals, Initializes the Flash interface and the Systick. */
  HAL_Init();

  /* USER CODE BEGIN Init */
  DTW_counter_init();
  /* USER CODE END Init */

  /* Configure the system clock */
  SystemClock_Config();

  /* USER CODE BEGIN SysInit */
/* Add bcb circular buffer to SerialTaskSend for usart1 -- PC monitor */
  #define NUMCIRBCB1  16 // Size of circular buffer of BCB for usart3
  ret = xSerialTaskSendAdd(&HUARTMON, NUMCIRBCB1, 1); // dma
  if (ret < 0) morse_trap(111); // Panic LED flashing
  /* USER CODE END SysInit */

  /* Initialize all configured peripherals */
  MX_GPIO_Init();
  MX_DMA_Init();
  MX_ADC1_Init();
  MX_USART1_UART_Init();
  MX_CAN1_Init();
  /* USER CODE BEGIN 2 */

  // Turn LEDs OFF
  HAL_GPIO_WritePin(GPIOB, GPIO_PIN_3|GPIO_PIN_4, GPIO_PIN_SET);

  /* USER CODE END 2 */

  /* Init scheduler */
  osKernelInitialize();

  /* USER CODE BEGIN RTOS_MUTEX */
  /* add mutexes, ... */
  /* USER CODE END RTOS_MUTEX */

  /* USER CODE BEGIN RTOS_SEMAPHORES */
  /* add semaphores, ... */
  /* USER CODE END RTOS_SEMAPHORES */

  /* USER CODE BEGIN RTOS_TIMERS */
  /* start timers, add new ones, ... */

  /* ADC summing, calibration, etc. */


  /* Setup semaphore for yprint and sprintf et al. */
  yprintf_init();

  /* USER CODE END RTOS_TIMERS */

  /* USER CODE BEGIN RTOS_QUEUES */
  /* add queues, ... */
  /* USER CODE END RTOS_QUEUES */

  /* Create the thread(s) */
  /* creation of defaultTask */
  defaultTaskHandle = osThreadNew(StartDefaultTask, NULL, &defaultTask_attributes);

  /* USER CODE BEGIN RTOS_THREADS */
  /* add threads, ... */
   Thrdret = xADCTaskCreate(1); // (arg) = priority
  if (Thrdret == NULL) morse_trap(117);
  
  /* Create serial task (priority) */
  // Task handle "osThreadId SerialTaskHandle" is global
  Thrdret = xSerialTaskSendCreate(osPriorityNormal); // Create task and set Task priority
  if (Thrdret == NULL) morse_trap(112);

  /* Create serial receiving task. */
  ret = xSerialTaskReceiveCreate(osPriorityNormal);
  if (ret != pdPASS) morse_trap(113);
  /* USER CODE END RTOS_THREADS */

  /* USER CODE BEGIN RTOS_EVENTS */
  /* add events, ... */
  /* USER CODE END RTOS_EVENTS */

  /* Start scheduler */
  osKernelStart();

  /* We should never get here as control is now taken by the scheduler */
  /* Infinite loop */
  /* USER CODE BEGIN WHILE */
  while (1)
  {
    /* USER CODE END WHILE */

    /* USER CODE BEGIN 3 */
  }
  /* USER CODE END 3 */
}

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
/* USER CODE BEGIN Header_StartDefaultTask */
/**
  * @brief  Function implementing the defaultTask thread.
  * @param  argument: Not used
  * @retval None
  */
uint32_t mctr = 0; // Debugging counter
uint32_t lctr = 20;
uint32_t ratectr = 0;
uint16_t* pjdr1 = (uint16_t*)(0x50040000 + 0x80); // Vrefint
uint16_t* pjdr2 = (uint16_t*)(0x50040000 + 0x80 + 0x04); // Vtemp
uint8_t diff = 0; // yprintf switch lines
uint8_t fet = 0;

/* Ribbon assignments of battery cable for use with BMSCable adaptor 
ribboncolorR = ribbon color sequence reversed from standard cables
ribboncolorS = ribbon color sequence standard 
pinnumberB   = IDC connector pin for battery cable (02/2022) */
char* ribboncolorR= "WHT     GRY     GRY     PUR     PUR     BLU     BLU     GRN     GRN     YEL     YEL     ORG     ORG     RED     RED     BRN    BRN    BLK";
char* ribboncolorS= "RED     ORG     ORG     YEL     YEL     GRN     GRN     BLU     BLU     PUR     PUR     GRY     GRY     WHT     WHT     BLK    BLK    BRN";
char* pinnumberB  = "12       3      13       4      14       5      15       6      16       7      17       8      18       9      19      10      20     11";
char* cellnumberB = " 1       2       3       4       5       6       7       8       9      10      11      12      13      14      15      16      17     18";

/* BQ ribbon assignment. */
char* ribboncolor = "GRY     BLU     PUR     GRN     BLU     YEL     GRN     ORG     YEL     RED     ORG     BRN     RED     BLK     BRN     WHT";
char* pinnumber   = "13       5      14       6      15       7      16       8      17       9      18      10      19      11      20      12 ";
char* cellnumber  = " 1       2       3       4       5       6       7       8       9      10      11      12      13      14      15      16 ";

char* test = "Quick Brown fox jumped over the lazy dogs back 0123456789\n\r";

/* USER CODE END Header_StartDefaultTask */
void StartDefaultTask(void *argument)
{
  /* USER CODE BEGIN 5 */
  uint32_t noteval = 0; // TaskNotifyWait notification word
  uint32_t notectr = 0; // Running count of notifications
  uint32_t notelim = 0; // Wait for notectr
  uint8_t state    = 0; // State machine sequence
//  uint8_t ledseq   = 0;

  struct SERIALSENDTASKBCB* pbuf1 = getserialbuf(&HUARTMON,256);
  if (pbuf1 == NULL) morse_trap(115);
  struct SERIALSENDTASKBCB* pbuf2 = getserialbuf(&HUARTMON,256);
  if (pbuf2 == NULL) morse_trap(116);

  yprintf(&pbuf1,"\n\rBegin %d",mctr++);

    HAL_GPIO_TogglePin(GPIOB,GPIO_PIN_3); // GRN LED
  /* Infinite loop */
  for(;;)
  {

    /* Wait for ADC new adc data (ADCTask.c) */
    xTaskNotifyWait(0,0xffffffff, &noteval, portMAX_DELAY);

   if (noteval & DEFAULTTASKBIT00)
   {
    notectr += 1;  // Running count of notifications



    /* Make monitor update rate reasonable. */
    ratectr += 1;
    if (ratectr < 2) continue;
    ratectr = 0;

    HAL_GPIO_TogglePin(GPIOB,GPIO_PIN_3); // GRN LED

    /* Index for just completed DMA buffer half. */
    uint8_t idxsum = adcsumidx ^ 1;
    float*   pfsum = &adcsumfilt[idxsum][0];
// STATES ------------------------------------------------------
#define RELAYDELAY 4
    switch (state)
    {
    case 0:
      lctr += 1; // Line counter for header
//HAL_GPIO_WritePin(GPIOB,GPIO_PIN_2 | GPIO_PIN_10,GPIO_PIN_RESET);
//#define SUMMEDINTEGER
#ifdef  SUMMEDINTEGER   
     uint32_t* psum = &adcsumdb[idxsum][0];
      if (lctr >= 8)
      {
        lctr = 0;
        yprintf(&pbuf1,"\n\rR%4u:",(adcommon.dmact - mctr));
        for (int i = 0; i < 16; i++)
        {
          yprintf(&pbuf1," %6u",(i+1));
        }
      }

      yprintf(&pbuf1,"\n\rI   :");
      for (int i = 0; i < 16; i++)
      {
        yprintf(&pbuf1," %6u",*(psum + i) );
      }
      mctr = adcommon.dmact;
#else
// Calibrated       

      float fprev = 0;
      float ftmp = 0;
      char* er;
      char* erhi = "HI";
      char* erlo = "LO";
      char* erno = "  ";
      char* erpack;
      char* erpackhi = "TOTALHI";
      char* erpackok = "TOTALOK";
      char* fetstatus;
      char* fetstatusoff = "FET OFF";
      char* fetstatuson  = "FET ON";

      extern uint32_t dwtdiff; 
  
      // Status line and column header
      if (*(pfsum + 15) > adc1.lc.flim_packhi)
      { // total voltage exceeds limit
        erpack = erpackhi;
        fet = 0; // Turn off external charger
      }
      else
      { // Total voltage not too high
        erpack = erpackok;
        fet = 1; // This may be turned off by the cell check
      }
      yprintf(&pbuf2,"\n\r\n%5d %s\n\r   ",dwtdiff,erpack);
 
      /* Header depends on adaptor, and battery box. */
    #define SIXTEENBOX
    #ifdef  SIXTEENBOX
      yprintf(&pbuf2,"\n\rPIN#   %s",pinnumberB);
      yprintf(&pbuf1,"\n\rREVRSE %s\n\r",ribboncolorR);
      yprintf(&pbuf1,"STNDRD %s\n\rCELL# ",ribboncolorS);
    #else
      yprintf(&pbuf2,"\n\rPIN#  %s",pinnumber);
      yprintf(&pbuf1,"\n\rCOLOR%s\n\rCELL",ribboncolor);
    #endif

      fprev = 0;
      for (int i = 0; i < 16; i++)
      {
        ftmp = *(pfsum + i) - fprev; // Individual cell volts
        er = erno; // default to no error
        if (ftmp > adc1.lc.flim_cellhi)
        { // Cell exceeds limit
          er = erhi; 
          fet = 0; // Turn off external charger
        }
        else if (ftmp < adc1.lc.flim_celllo)
        { // Cell too low for standard charge current
          er = erlo;
          fet = 0; // Turn off external charger
        }
        if (i == 0)
          yprintf(&pbuf2,"%3i %s",i+1,er);
        else
          yprintf(&pbuf2,"%5i %s",i+1,er);
        fprev = *(pfsum + i); 
      }  
  
      // Individual cells: Differences
      yprintf(&pbuf1,"\n\rD: ");
      fprev = 0;
      for (int i = 0; i < 16; i++)
      {
        yprintf(&pbuf1,"%7.4f ",*(pfsum + i) - fprev);
        fprev = *(pfsum + i);
      }

      // Battery string taps: ground-to-cell voltage
      yprintf(&pbuf1,"\n\rN:");
      for (int i = 0; i < 16; i++)
      {
        yprintf(&pbuf1,"%7.4f ",*(pfsum + i));
      }
      mctr = adcommon.dmact;

      // FET for external charger update
      if (fet == 0)
        fetstatus = fetstatusoff;
      else
        fetstatus = fetstatuson;

      // RED led on when external charger fet ON
      HAL_GPIO_WritePin(GPIOB,GPIO_PIN_9,fet); // FET drive
      HAL_GPIO_WritePin(GPIOB,GPIO_PIN_4,(fet ^ 1)); // RED led

      yprintf(&pbuf2,"\n\rSTATUS: %s",fetstatus);

      // Vref and Vtemp registers
      yprintf(&pbuf1," :   Vref %6u Vtemp %u",*pjdr1, *(pjdr1+2));
#endif
      notelim = notectr + RELAYDELAY;

 #define CHECKRELAYEDWIRES
  #ifndef CHECKRELAYEDWIRES
      HAL_GPIO_WritePin(GPIOB,GPIO_PIN_2 | GPIO_PIN_10,GPIO_PIN_RESET);
      notelim = notectr + RELAYDELAY;
      state = 2; // Do the delay, then continue w/o relay wire check
      break;
  #else
      state = 1; 
      // Turn fets and relays ON to switch ADC inputs
      HAL_GPIO_WritePin(GPIOB,GPIO_PIN_2 | GPIO_PIN_10,GPIO_PIN_SET);
     /* No break: FALL THRU */
  #endif     

    case 1: // Wait out delay for readings to stabilize
      if ((int)(notectr - notelim) < 0) break;

      // Here, sufficient delay to use readings
      yprintf(&pbuf1,"\n\rZ:");

      state = 2;
yprintf(&pbuf1,"\n\rR:");
 for (int i = 0; i < 16; i++)
 {
   yprintf(&pbuf1,"%7.4f ",*(pfsum + i));
 }
      yprintf(&pbuf1,"\n\rW :");

      /* Current sense wire. */
      uint8_t cx = 3;
        if (*(pfsum + cx) > adc1.lc.flim_relayhi) // Relay switched wire: greater than = Open
        { // Here, wire must be connected to some CELL and not ground
          yprintf(&pbuf2," %s %s %0.3f","CUR SENSE","WRONG",*(pfsum + cx));
        }
        else if (*(pfsum + cx) < adc1.lc.flim_relaylo) // Relay switched wire: less than = OK
        { // Here, wire shows small or no voltage, hence continuity.
          yprintf(&pbuf2," %s %s %0.3f","CUR SENSE","GOOD",*(pfsum + cx));
        } // Here, input pin not connected to anything
        else
          yprintf(&pbuf2," %s %s %0.3f","CUR SENSE","OPEN",*(pfsum + cx));

      /* Cell #17: pin/adc value; difference #17-#16. */
      yprintf(&pbuf2,"\n\r Pin 20: %7.4f  Cell #17: %7.4f",*(pfsum + 5),*(pfsum + 5) - *(pfsum + 15) );

      /* Cell #18: pin/adc value; difference #18-#17. */
      yprintf(&pbuf2,"\n\r Pin 11: %7.4f  Cell #18: %7.4f",*(pfsum + 3),*(pfsum + 3) - *(pfsum + 5) );

      // Turn fets and relays OFF to switch ADC inputs
      HAL_GPIO_WritePin(GPIOB,GPIO_PIN_2 | GPIO_PIN_10,GPIO_PIN_RESET);
      notelim = notectr + RELAYDELAY;
      state = 2;

    case 2:
      if ((int)(notectr - notelim) < 0) break;
      state = 0;
      break;    

  }

 
 }
  }
  /* USER CODE END 5 */
}

/**
  * @brief  Period elapsed callback in non blocking mode
  * @note   This function is called  when TIM15 interrupt took place, inside
  * HAL_TIM_IRQHandler(). It makes a direct call to HAL_IncTick() to increment
  * a global variable "uwTick" used as application time base.
  * @param  htim : TIM handle
  * @retval None
  */
void HAL_TIM_PeriodElapsedCallback(TIM_HandleTypeDef *htim)
{
  if (htim->Instance == TIM15) {
    HAL_IncTick();
  }
}

/**
  * @brief  This function is executed in case of error occurrence.
  * @retval None
  */
void Error_Handler(void)
{
  /* USER CODE BEGIN Error_Handler_Debug */
  /* User can add his own implementation to report the HAL error return state */
  __disable_irq();
  while (1)
  {
  }
  /* USER CODE END Error_Handler_Debug */
}

#ifdef  USE_FULL_ASSERT
/**
  * @brief  Reports the name of the source file and the source line number
  *         where the assert_param error has occurred.
  * @param  file: pointer to the source file name
  * @param  line: assert_param error line source number
  * @retval None
  */
void assert_failed(uint8_t *file, uint32_t line)
{
  /* USER CODE BEGIN 6 */
  /* User can add his own implementation to report the file name and line number,
     ex: printf("Wrong parameters value: file %s on line %d\r\n", file, line) */
  /* USER CODE END 6 */
}
#endif /* USE_FULL_ASSERT */

/************************ (C) COPYRIGHT STMicroelectronics *****END OF FILE****/
