GliderWinchItems/BMScable/pcb/BMScableL431/BMScableL431.ioc

Mcu.UserName=STM32L431RBTx
PA0.Signal=ADCx_IN5
PA1.Signal=ADCx_IN6
PA10.Signal=USART1_RX
PA11.Signal=CAN1_RX
PA12.Signal=CAN1_TX
PA2.Signal=ADCx_IN7
PA3.Signal=ADCx_IN8
PA4.Signal=ADCx_IN9
PA5.Signal=ADCx_IN10
PA6.Signal=ADCx_IN11
PA7.Signal=ADCx_IN12
PA9.Signal=USART1_TX
PB0.Signal=ADCx_IN15
PB1.Signal=ADCx_IN16
PB10.GPIO_Label=RY2-FET
PB10.Signal=GPIO_Output
PB2.GPIO_Label=RY1-FET
PB2.Signal=GPIO_Output
PB9.GPIO_Label=Q1-FET
PB9.Signal=GPIO_Output
PC0.Signal=ADCx_IN1
PC1.Signal=ADCx_IN2
PC2.Signal=ADCx_IN3
PC3.Signal=ADCx_IN4
PC4.Signal=ADCx_IN13
PC5.Signal=ADCx_IN14
