GliderWinchItems/BMScable/pcb/BMScableL431/Core/Inc/main.h

#define DEFAULTTASKBIT00 (1 << 0)  // Task notification bit (from ADCtask.c)
#define RY1_FET_Pin GPIO_PIN_2
#define RY1_FET_GPIO_Port GPIOB
#define RY2_FET_Pin GPIO_PIN_10
#define RY2_FET_GPIO_Port GPIOB
#define LED_GRN_Pin GPIO_PIN_3
#define LED_GRN_GPIO_Port GPIOB
#define LED_RED_Pin GPIO_PIN_4
#define LED_RED_GPIO_Port GPIOB
#define Q1_FET_Pin GPIO_PIN_9
#define Q1_FET_GPIO_Port GPIOB
#define HUARTMON  huart1 // uart  for PC monitoring
