GliderWinchItems/BMScable/pcb/BMScableL431/Ourwares/morse.c

/******************************************************************************
* File Name          : morse.c
* Date First Issued  : 02/13/2019
* Description        : Morse code
*******************************************************************************/
#include <stdint.h>
#include "DTW_counter.h"
#include "stm32l4xx_hal.h"

#define TICPERSEC (80000000)
#define TIC_DIT (TICPERSEC/6)
#define TIC_DAH (TIC_DIT*4)
#define TIC_IDIT (TIC_DIT*1.3)
#define TIC_ICHAR (TIC_IDIT*4)
#define TIC_IWORD (TIC_ICHAR *3)
#define TIC_PAUSE (TICPERSEC*1) // Pause between code sequence

#define LEDALL (GPIO_PIN_3|GPIO_PIN_4)

struct MORSE_ELEMENT
{
	char c;
	uint8_t dd;
	uint8_t ct;
};

const struct MORSE_ELEMENT mrse[] = {
{'A', 0b01000000, 2}, 
{'B', 0b10000000, 4}, 
{'C', 0b10100000, 4}, 
{'D', 0b10000000, 3}, 
{'E', 0b00000000, 1}, 
{'F', 0b00100000, 4}, 
{'G', 0b11000000, 3}, 
{'H', 0b00000000, 4},
{'I', 0b00000000, 2}, 
{'J', 0b01110000, 4}, 
{'K', 0b10100000, 3}, 
{'L', 0b01000000, 4}, 
{'M', 0b11000000, 2}, 
{'N', 0b10000000, 2}, 
{'O', 0b11100000, 3}, 
{'P', 0b01100000, 4}, 
{'Q', 0b11010000, 4}, 
{'R', 0b01000000, 3}, 
{'S', 0b00000000, 3}, 
{'T', 0b10000000, 1}, 
{'U', 0b00100000, 3}, 
{'V', 0b00010000, 4}, 
{'W', 0b01100000, 3}, 
{'X', 0b10010000, 4}, 
{'Y', 0b10110000, 4}, 
{'Z', 0b11000000, 4}, 
{'0', 0b11111000, 5}, 
{'1', 0b01111000, 5}, 
{'2', 0b00111000, 5}, 
{'3', 0b00011000, 5}, 
{'4', 0b00001000, 5}, 
{'5', 0b00000000, 5}, 
{'6', 0b10000000, 5}, 
{'7', 0b11000000, 5}, 
{'8', 0b11100000, 5}, 
{'9', 0b11110000, 5}, 
{'.', 0b01010100, 6}, 
{',', 0b11001100, 6}, 
{'?', 0b00110000, 6}, 
{'-', 0b10001000, 5}, 
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
};

/* *************************************************************************
 * static void delay(uint32_t ticks, uint8_t on);
 * @brief	: Delay based on DTW counter with LEDs ON
 * @param	: ticks = DTW count to delay
 * @param	: on = GPIO_PIN_RESET or GPIO_PIN_SET
 * *************************************************************************/
static void delay(uint32_t ticks, uint8_t on)
{
	uint32_t tx = DTWTIME + ticks;
	while ((int32_t)(tx - DTWTIME) > 0)
	{
			HAL_GPIO_WritePin(GPIOB, LEDALL, on); 
	}
	return;
}

/* *************************************************************************
 * static void morse_generate(char c);
 *	@brief	: c = character to send as Morse cdoe
 * *************************************************************************/
static void morse_generate(char c)
{
	const struct MORSE_ELEMENT* ptbl = mrse;
	int i;
	uint8_t ct;
	uint8_t dd;
	
	for (i = 0; i < (74 - 16); i++)
	{
		if (ptbl->c == c)
		{
				ct = ptbl->ct;
				dd = ptbl->dd;	
				while (ct > 0)
				{
					if ((dd & 0x80) == 0)
					{ // Here, dot
						delay(TIC_DIT, GPIO_PIN_RESET);
					}
					else
					{ // Here, dash
						delay(TIC_DAH, GPIO_PIN_RESET);						
					}
					delay(TIC_IDIT, GPIO_PIN_SET);
					dd = dd << 1;
					ct -= 1;
				}
				delay(TIC_ICHAR,GPIO_PIN_SET);
				return;
		}
		ptbl++;
	}	
	return;
}
/* *************************************************************************
 * void morse_string(char* p);
 *	@brief	: Send a character string as Morse code
 * @param	: p = pointer to string
 * *************************************************************************/
void morse_string(char* p)
{
	while(*p != 0)
	{
		if (*p != ' ')
		{
			morse_generate(*p++);
		}
		else
		{
			delay(TIC_IWORD,GPIO_PIN_SET);
			p++;
		}
	}

	return;		
}
/* *************************************************************************
 * void morse_number(uint32_t n);
 *	@brief	: Send a character string as Morse code
 * @param	: nx = number to send
 * *************************************************************************/
void morse_number(uint32_t nx)
{
	char c[16];
	int i = 0;
	do
	{
		c[i] = (nx % 10) + '0';
		nx = nx/10;
		i += 1;
	} while (nx != 0);

	while (--i >= 0)
	{
		morse_generate(c[i]);

	}
	delay(TIC_IWORD,GPIO_PIN_SET);
	return;
}
/* *************************************************************************
 * void morse_trap(uint32_t x);
 *	@brief	: Disable interrupts, Send 'x' and endless loop
 * @param	: x = trap number to flash
 * *************************************************************************/
void morse_trap(uint32_t x)
{
	/* Disable global interrupts */
__asm__ volatile ("CPSID I");
	while(1==1)
	{
		morse_number(x);
		delay(TIC_PAUSE,GPIO_PIN_SET);	
	}
}
/* *************************************************************************
 * void morse_hex(uint32_t n);
 *	@brief	: Send a  hex number, skip leading zeroes
 * @param	: nx = number to send
 * *************************************************************************/
static const char h[16] = {'0','1','2','3','4','5','6','7','8','9','A','B','C','D','E','F'};
void morse_hex(uint32_t nx)
{
	uint8_t c;
	uint8_t sw = 0;
	int8_t i;

	morse_generate('X');	// Hex prefix (but skip '0' in front of X)

	uint32_t mask = 0xf0000000;

	if (nx == 0)
	{
		morse_generate('0');
		return;
	}
	
	for (i = 0; i < 8; i++)
	{
		if (((nx & mask) != 0) || (sw != 0))
		{
			sw = 1;
			c = h[(nx >> 28)];
			morse_generate(c);
		}
		nx = nx << 4;
	}  
	delay(TIC_IWORD,GPIO_PIN_SET);
	return;	
}
