GliderWinchItems/BMScable/(commit log)

2020-07-25 getting started with BMS cable tester using Nucleo board
    [bmscable.brd, bmscable.sch, pinusage.ods, resistor_dividers.ods]
2020-07-26 save work
    [bmscable.brd, bmscable.sch, pinusage.ods]
2020-11-26 update perfboard wiring
2020-11-27 update wiring
2020-11-29 backup work
    [bmscable.brd, bmscable.sch]
2021-02-24 pcb design and layout, first cut.
    [adc-divider.ods, bmscable.brd, bmscable.sch, bmscableL431.brd, bmscableL431.sch, bmscablef405.brd, bmscablef405.sch, pinusage.ods]
2021-02-25 add eagleNucleo. Optional L431 or Nucleo for processorizing it.
    [bmscableNucleo.brd, bmscableNucleo.sch]
2021-02-26 pcb Nucleo nearing completion. Renumbered parts
    [adc-divider.ods, bmscable.sch, bmscableNucleo.brd, bmscableNucleo.sch]
2021-02-26 bmscableNucleo layout cleanup.
    [bmscableNucleo.brd, bmscableNucleo.sch]
2021-02-27 added Nucleo to header for CAN, I2C1. Added Schottky diodes for reverse protection. Added numbers to cell vias
    [bmscableNucleo.brd, bmscableNucleo.sch]
2021-02-28 Added polarity LEDs, ISO1042 CAN driver, spare fet
    [bmscableNucleo.brd, bmscableNucleo.sch]
2021-03-02 bmscableNucleo.docx update
    [bmscableNucleo.brd, bmscableNucleo.sch]
2021-04-25 Added caps for RC filtering. PB6,7 for I2C1 to Nucleo. GRN-RED led to Nucleo changed to PC10,11. Added hole for User pushbutton but it is under FTDI, when FTDI mounted horizontal. Cosmetic items to F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
    [bmscableNucleo.brd, bmscableNucleo.sch]
2021-04-26 Added missing FET gate, PB2 to Nucleo header connection. Added pcb reset to Nucleo RESET. Cleaned up some large font labels
    [bmscableNucleo.brd, bmscableNucleo.sch]
2021-05-27 update before sending board to PCBCart.com
    [bmscableNucleo.brd, bmscableNucleo.sch]
2021-05-28 Add gerber zip
2021-07-30 add STM32L431 openocd notes
2021-08-03 Begin sw development. morse.c working. yprintf not.
    [bmscablev4.brd, bmscablev4.sch]
2021-08-09 backup work. adc filtering working
2021-08-13 update work
    [board2.ods, boards.ods, ribbon_cable_seq.ods]
2021-08-17 back and save work. Calibrating board #1. Revised ADC scan sequence so mapping is not needed.
    [boards.ods]
2021-08-18 added external charger fet on-off
2021-08-21 update and backup work.
    [boards.ods, pcb-frame.scad, pcb-frame.stl]
2021-08-24 save and backup
    [adc-divider.ods, boards.ods, calibration-aid.ods, pcb-frame.scad, pcb-frame.stl, ribbon_cable_seq.ods]
2022-03-24 update ribbon colors
    [adc-divider.ods, boards.ods, calibration-aid.ods]
