GliderWinchItems/BMScable/(notices)

Notices in the files:
pcb/BMScableL431/Core/Src/main.c:
© Copyright (c) 2021 STMicroelectronics.
All rights reserved.
This software component is licensed by ST under Ultimate Liberty license
